mgiugliano/MorsePaddle2USB/photo&circuit/Schematic.pdf

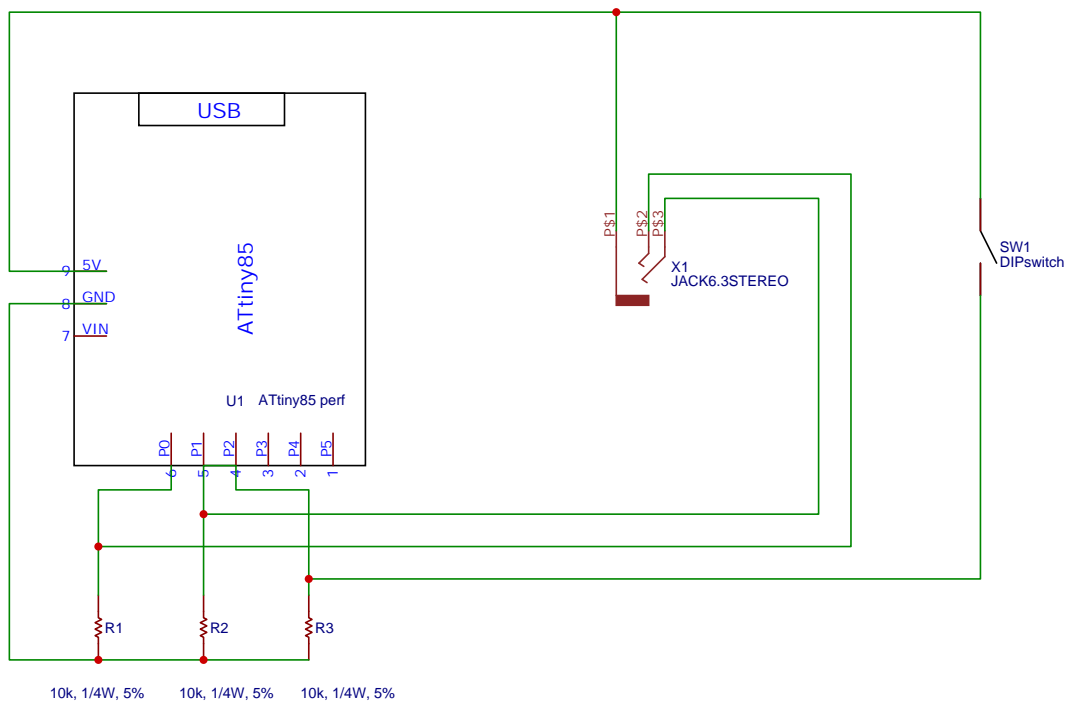
[picture p4: page 1]

Drawn By: Michele Giugliano
